Jkillelea/heater-driver/driver.kicad_pcb

## KiCad design driver.kicad_pcb (2019-01-31)

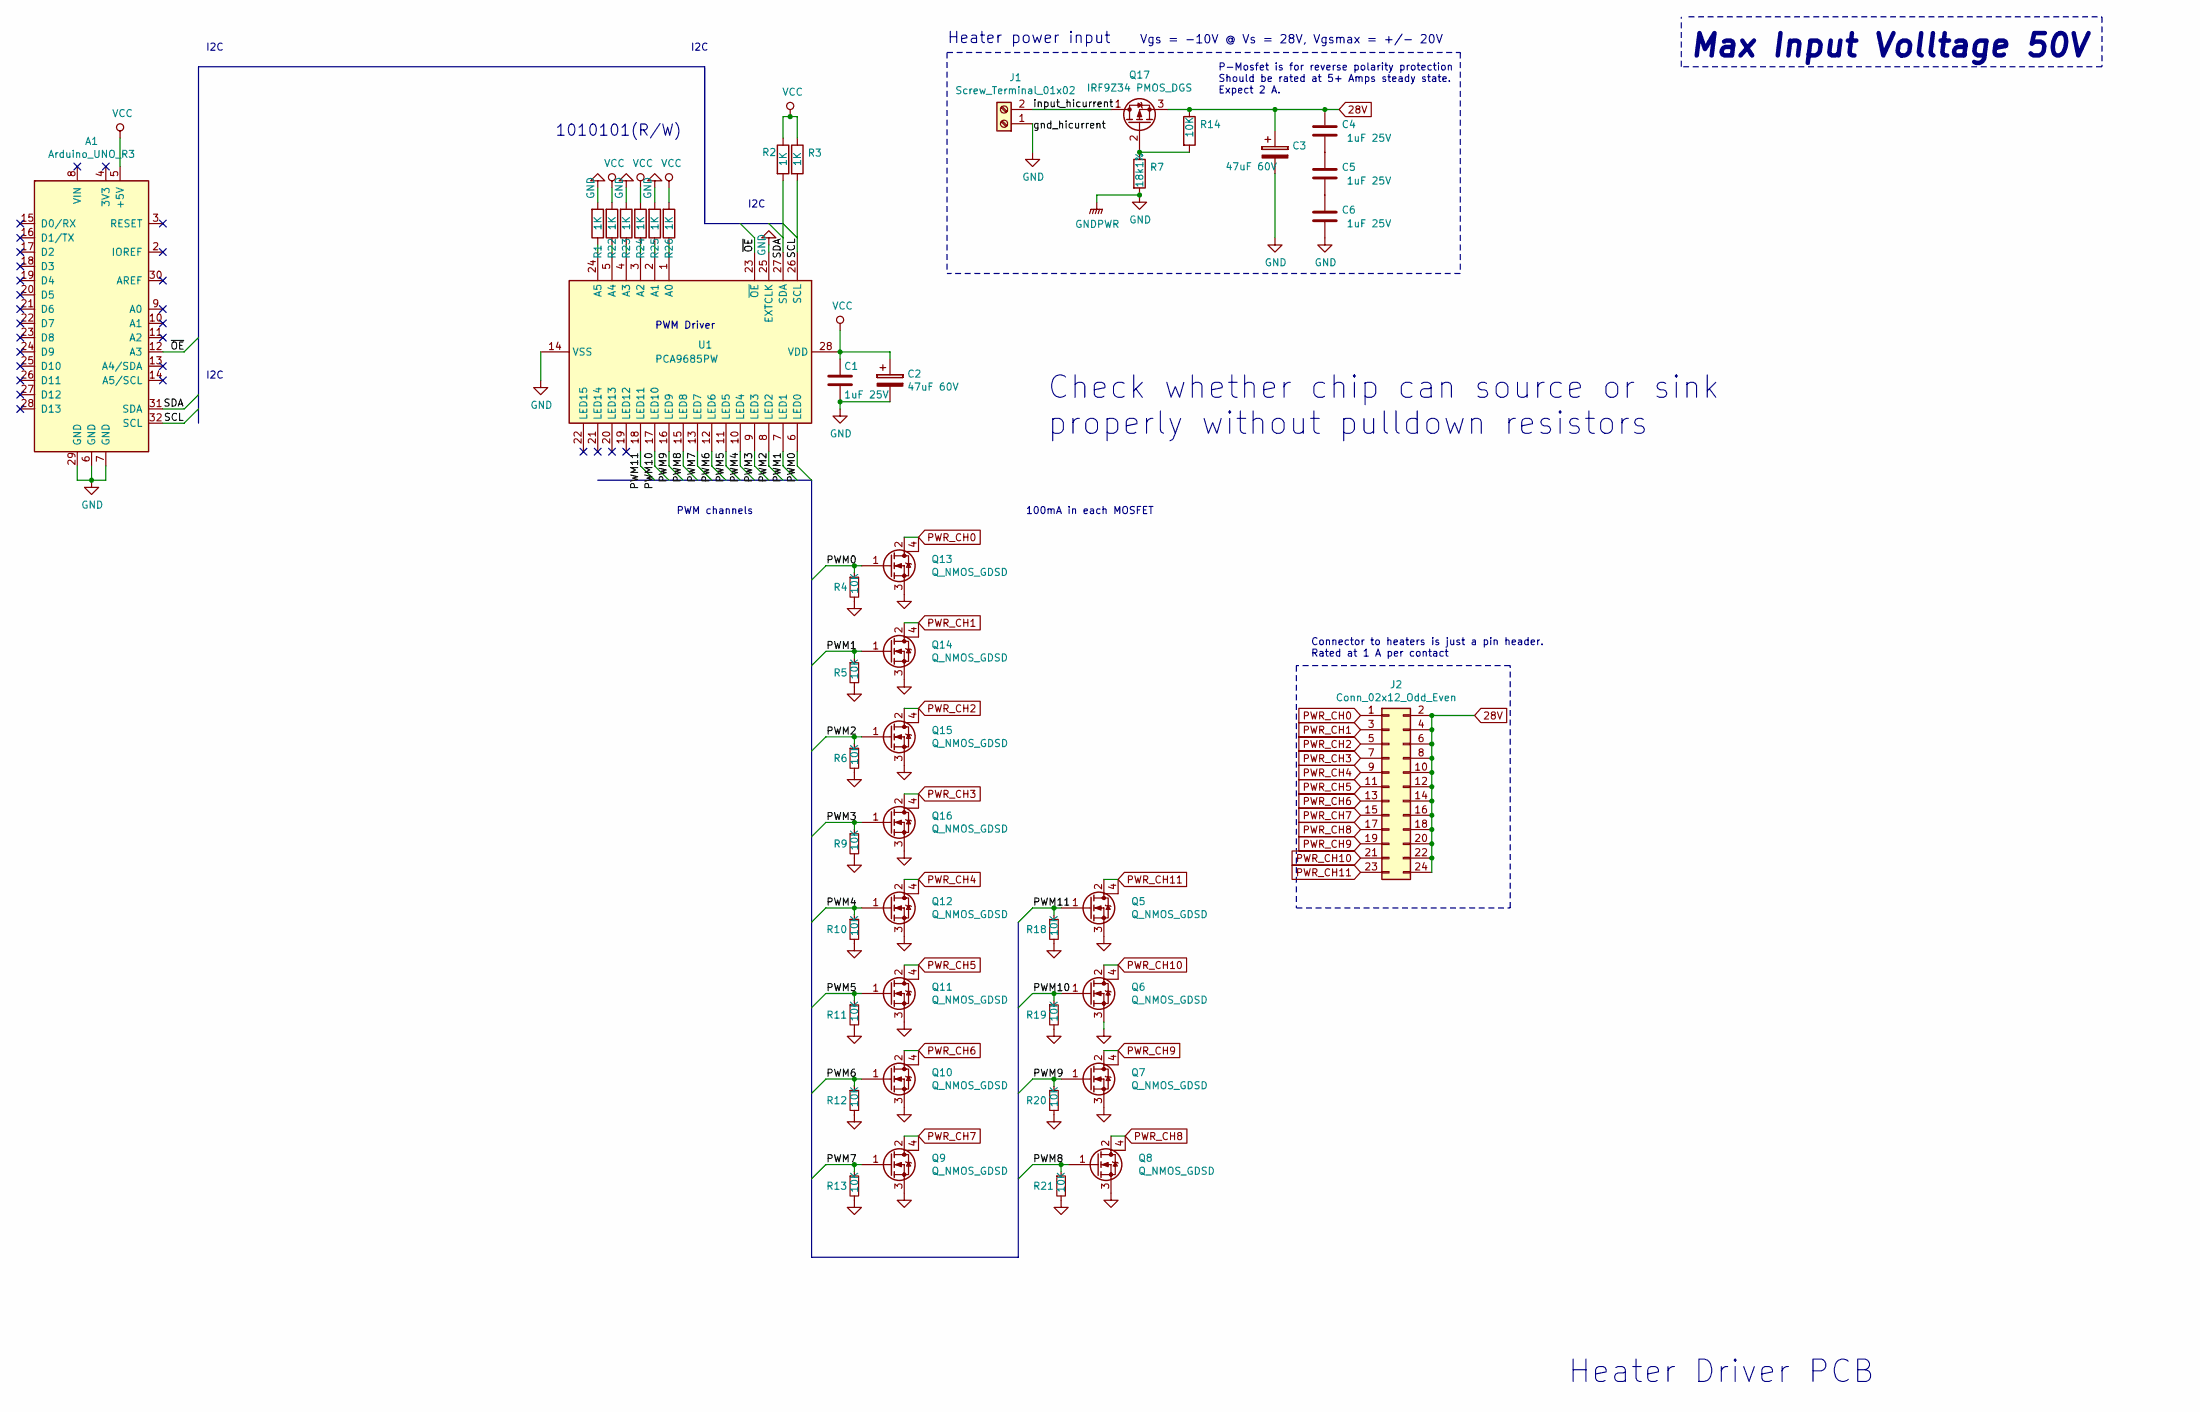
[picture p1: schematic driver.sch]

Parts:
A1: Arduino_UNO_R3
C1, C4, C5, C6: 1uF 25V; C_1206_3216Metric_Pad1.42x1.75mm_HandSolder
C2, C3: 47uF 60V; CP_Radial_D6.3mm_P2.50mm
J1: Screw_Terminal_01x02; TerminalBlock_MetzConnect_Type055_RT01502HDWU_1x02_P5.00mm_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
J2: Conn_02x12_Odd_Even; PinHeader_2x12_P2.54mm_Vertical
Q5, Q6, Q7, Q8, Q9, Q10, Q11, Q12, Q13, Q14, Q15, Q16: Q_NMOS_GDSD; SOT-223
Q17: IRF9Z34 PMOS_DGS; TO-220-3_Vertical
R1, R2, R3, R22, R23, R24, R25, R26: 1K; R_0805_2012Metric_Pad1.15x1.40mm_HandSolder
R4, R5, R6, R9, R10, R11, R12, R13, R14, R18, R19, R20, R21: 10K; R_1206_3216Metric_Pad1.42x1.75mm_HandSolder
R7: 18k1%; R_1206_3216Metric_Pad1.42x1.75mm_HandSolder
U1: PCA9685PW; TSSOP-28_4.4x9.7mm_P0.65mm

Connections:
28V: C3.1, C4.1, J2.2, J2.4, J2.6, J2.8, J2.10, J2.12, J2.14, J2.16, J2.18, J2.20, J2.22, J2.24, Q17.3 (S), R14.1
/PWM0: Q13.1 (G), R4.1, U1.6 (LED0)
/PWM1: Q14.1 (G), R5.1, U1.7 (LED1)
/PWM2: Q15.1 (G), R6.1, U1.8 (LED2)
/PWM3: Q16.1 (G), R9.1, U1.9 (LED3)
/PWM4: Q12.1 (G), R10.1, U1.10 (LED4)
/PWM5: Q11.1 (G), R11.1, U1.11 (LED5)
/PWM6: Q10.1 (G), R12.1, U1.12 (LED6)
/PWM7: Q9.1 (G), R13.1, U1.13 (LED7)
/PWM8: Q8.1 (G), R21.1, U1.15 (LED8)
/PWM9: Q7.1 (G), R20.1, U1.16 (LED9)
/PWM10: Q6.1 (G), R19.1, U1.17 (LED10)
/PWM11: Q5.1 (G), R18.1, U1.18 (LED11)
/SCL: A1.32 (SCL), R3.2, U1.26 (SCL)
/SDA: A1.31 (SDA), R2.2, U1.27 (SDA)
/input_hicurrent: J1.2, Q17.1 (D)
/~OE: A1.12 (A3), U1.23 (~OE)
GND: A1.6 (GND), A1.7 (GND), A1.29 (GND), C1.2, C2.2, C3.2, C6.2, J1.1, Q5.3 (S), Q6.3 (S), Q7.3 (S), Q8.3 (S), Q9.3 (S), Q10.3 (S), Q11.3 (S), Q12.3 (S), Q13.3 (S), Q14.3 (S), Q15.3 (S), Q16.3 (S), R1.2, R4.2, R5.2, R6.2, R7.2, R9.2, R10.2, R11.2, R12.2, R13.2, R18.2, R19.2, R20.2, R21.2, R23.2, R25.2, U1.14 (VSS), U1.25 (EXTCLK)
unnamed: C4.2, C5.1
unnamed: C5.2, C6.1
unnamed: Q17.2 (G), R7.1, R14.2
unnamed: R1.1, U1.24 (A5)
unnamed: R22.1, U1.5 (A4)
unnamed: R23.1, U1.4 (A3)
unnamed: R24.1, U1.3 (A2)
unnamed: R25.1, U1.2 (A1)
unnamed: R26.1, U1.1 (A0)
PWR_CH0: J2.1, Q13.2 (D), Q13.4 (D)
PWR_CH1: J2.3, Q14.2 (D), Q14.4 (D)
PWR_CH2: J2.5, Q15.2 (D), Q15.4 (D)
PWR_CH3: J2.7, Q16.2 (D), Q16.4 (D)
PWR_CH4: J2.9, Q12.2 (D), Q12.4 (D)
PWR_CH5: J2.11, Q11.2 (D), Q11.4 (D)
PWR_CH6: J2.13, Q10.2 (D), Q10.4 (D)
PWR_CH7: J2.15, Q9.2 (D), Q9.4 (D)
PWR_CH8: J2.17, Q8.2 (D), Q8.4 (D)
PWR_CH9: J2.19, Q7.2 (D), Q7.4 (D)
PWR_CH10: J2.21, Q6.2 (D), Q6.4 (D)
PWR_CH11: J2.23, Q5.2 (D), Q5.4 (D)
VCC: A1.5 (+5V), C1.1, C2.1, R2.1, R3.1, R22.2, R24.2, R26.2, U1.28 (VDD)

Notes on the sheet:
Heater power input
PWM Driver
P-Mosfet is for reverse polarity protection Should be rated at 5+ Amps steady state. Expect 2 A.
I2C
PWM channels
100mA in each MOSFET
Connector to heaters is just a pin header. Rated at 1 A per contact
Heater Driver PCB
Check whether chip can source or sink properly without pulldown resistors
1010101(R/W)
Vgs = -10V @ Vs = 28V, Vgsmax = +/- 20V
Max Input Volltage 50V

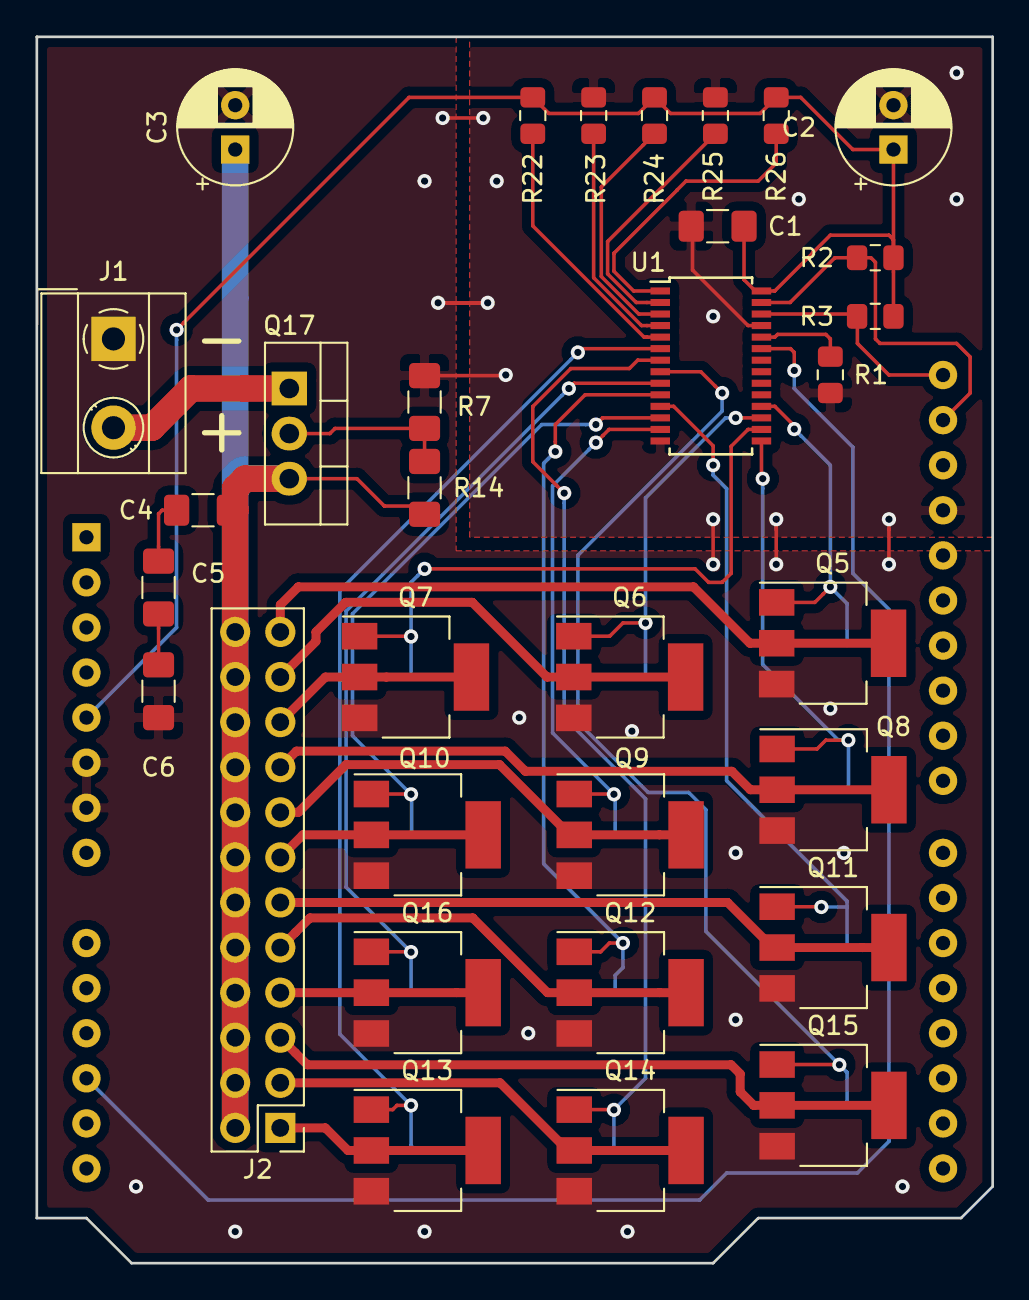
[picture p2: board driver.kicad_pcb from above]

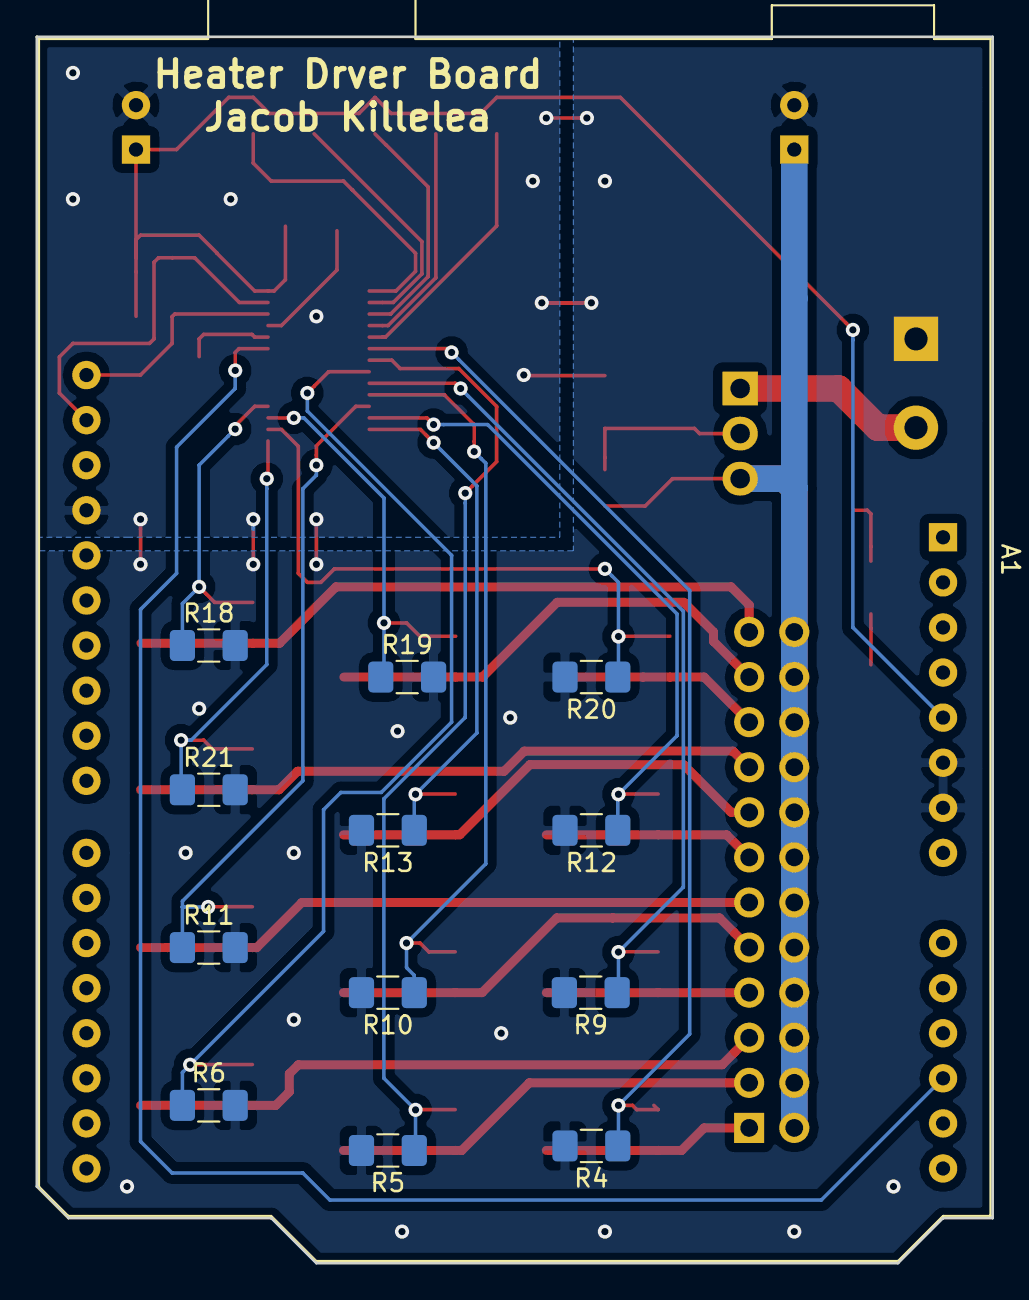
[picture p3: board driver.kicad_pcb from below]

Board: 2 copper layers, 53.8 x 69.1 mm, 45 parts (13 on the bottom side), 40 nets.
