Jkillelea/heater-driver/(commit log)

2019-01-19 28V heater power input, reverse polarity protection, early BOM
    [driver.sch]
2019-01-19 connector selected, beginning routing
    [driver.kicad_pcb, driver.sch]
2019-01-22 reroute schematic + component placement
    [driver.kicad_pcb, driver.sch]
2019-01-26 Trudy's notes
    [driver.kicad_pcb, driver.sch]
2019-01-26 add pulldown resistors
    [driver.kicad_pcb, driver.sch]
2019-01-26 ground extclk as per datasheet
    [driver.sch]
2019-01-26 change address
    [driver.kicad_pcb, driver.sch]
2019-01-27 Change all resistors to 10K 0805. More routing and placement
    [driver.kicad_pcb, driver.sch]
2019-01-28 remove capacitor footprints and organize.
    [driver.sch]
2019-01-28 replace zener with voltage divdier, swap MOSFETs, update footprints, separate power and signal ground planes
    [driver.kicad_pcb, driver.sch]
2019-01-30 Capacitor updates + voltage limit 50V + routing
    [driver.kicad_pcb, driver.sch]
2019-01-30 Remove reset button, finalize capacitor sizes
    [driver.kicad_pcb, driver.sch]
2019-01-30 resistor value/footprint changes and associated routing changes
    [driver.kicad_pcb, driver.sch]
2019-01-30 routing and placement
    [driver.kicad_pcb]
2019-01-31 misc routing updates
    [driver.kicad_pcb]
2019-01-31 polarity markings on terminal block, routing
    [driver.kicad_pcb]
